jbbjarnason/hot-tub/tub.png

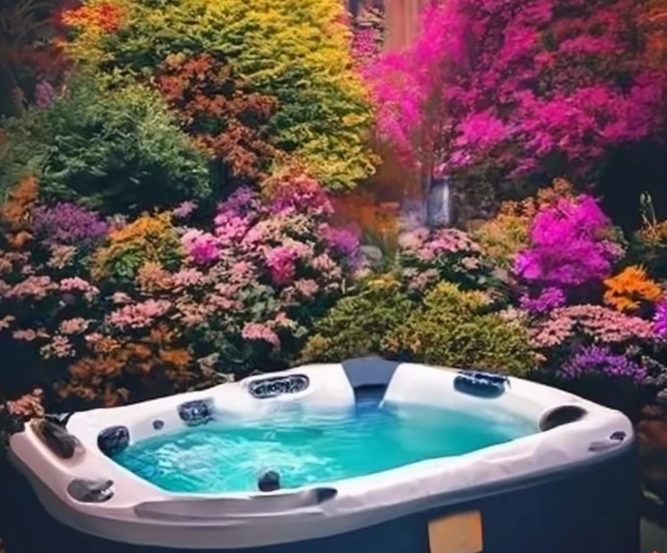
tub.png
