jbbjarnason/hot-tub/tub2.jpg

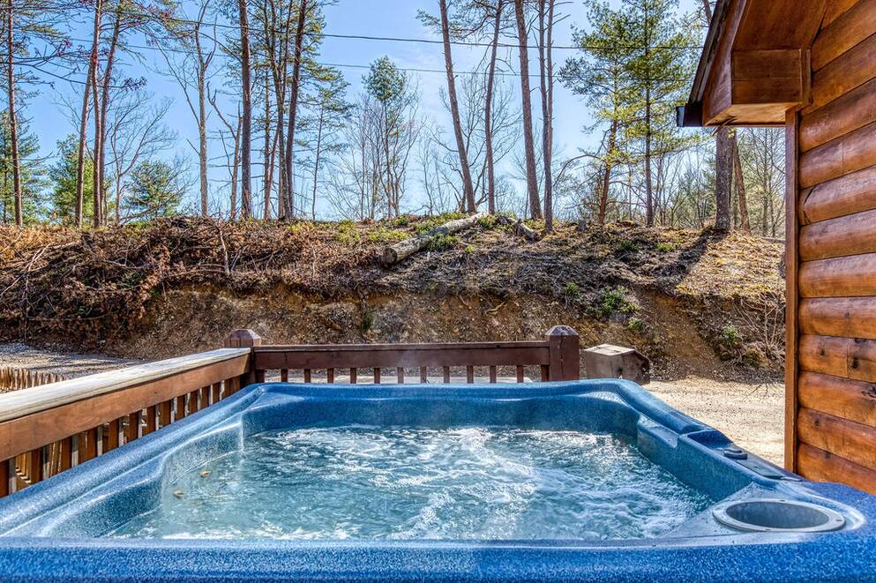
tub2.jpg
