jbbjarnason/hot-tub/readme.md

# resources

https://github.com/m5stack/M5Module-2Relay-13.2
https://github.com/nielsnl68/esphome-components/tree/main/components/m5stack4relay
