jbbjarnason/hot-tub/tub.jpg

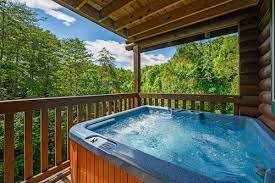
tub.jpg
