jbbjarnason/hot-tub/pcb/jacuzzi.kicad_pcb

## KiCad design pcb/jacuzzi.kicad_pcb (2024-08-04)

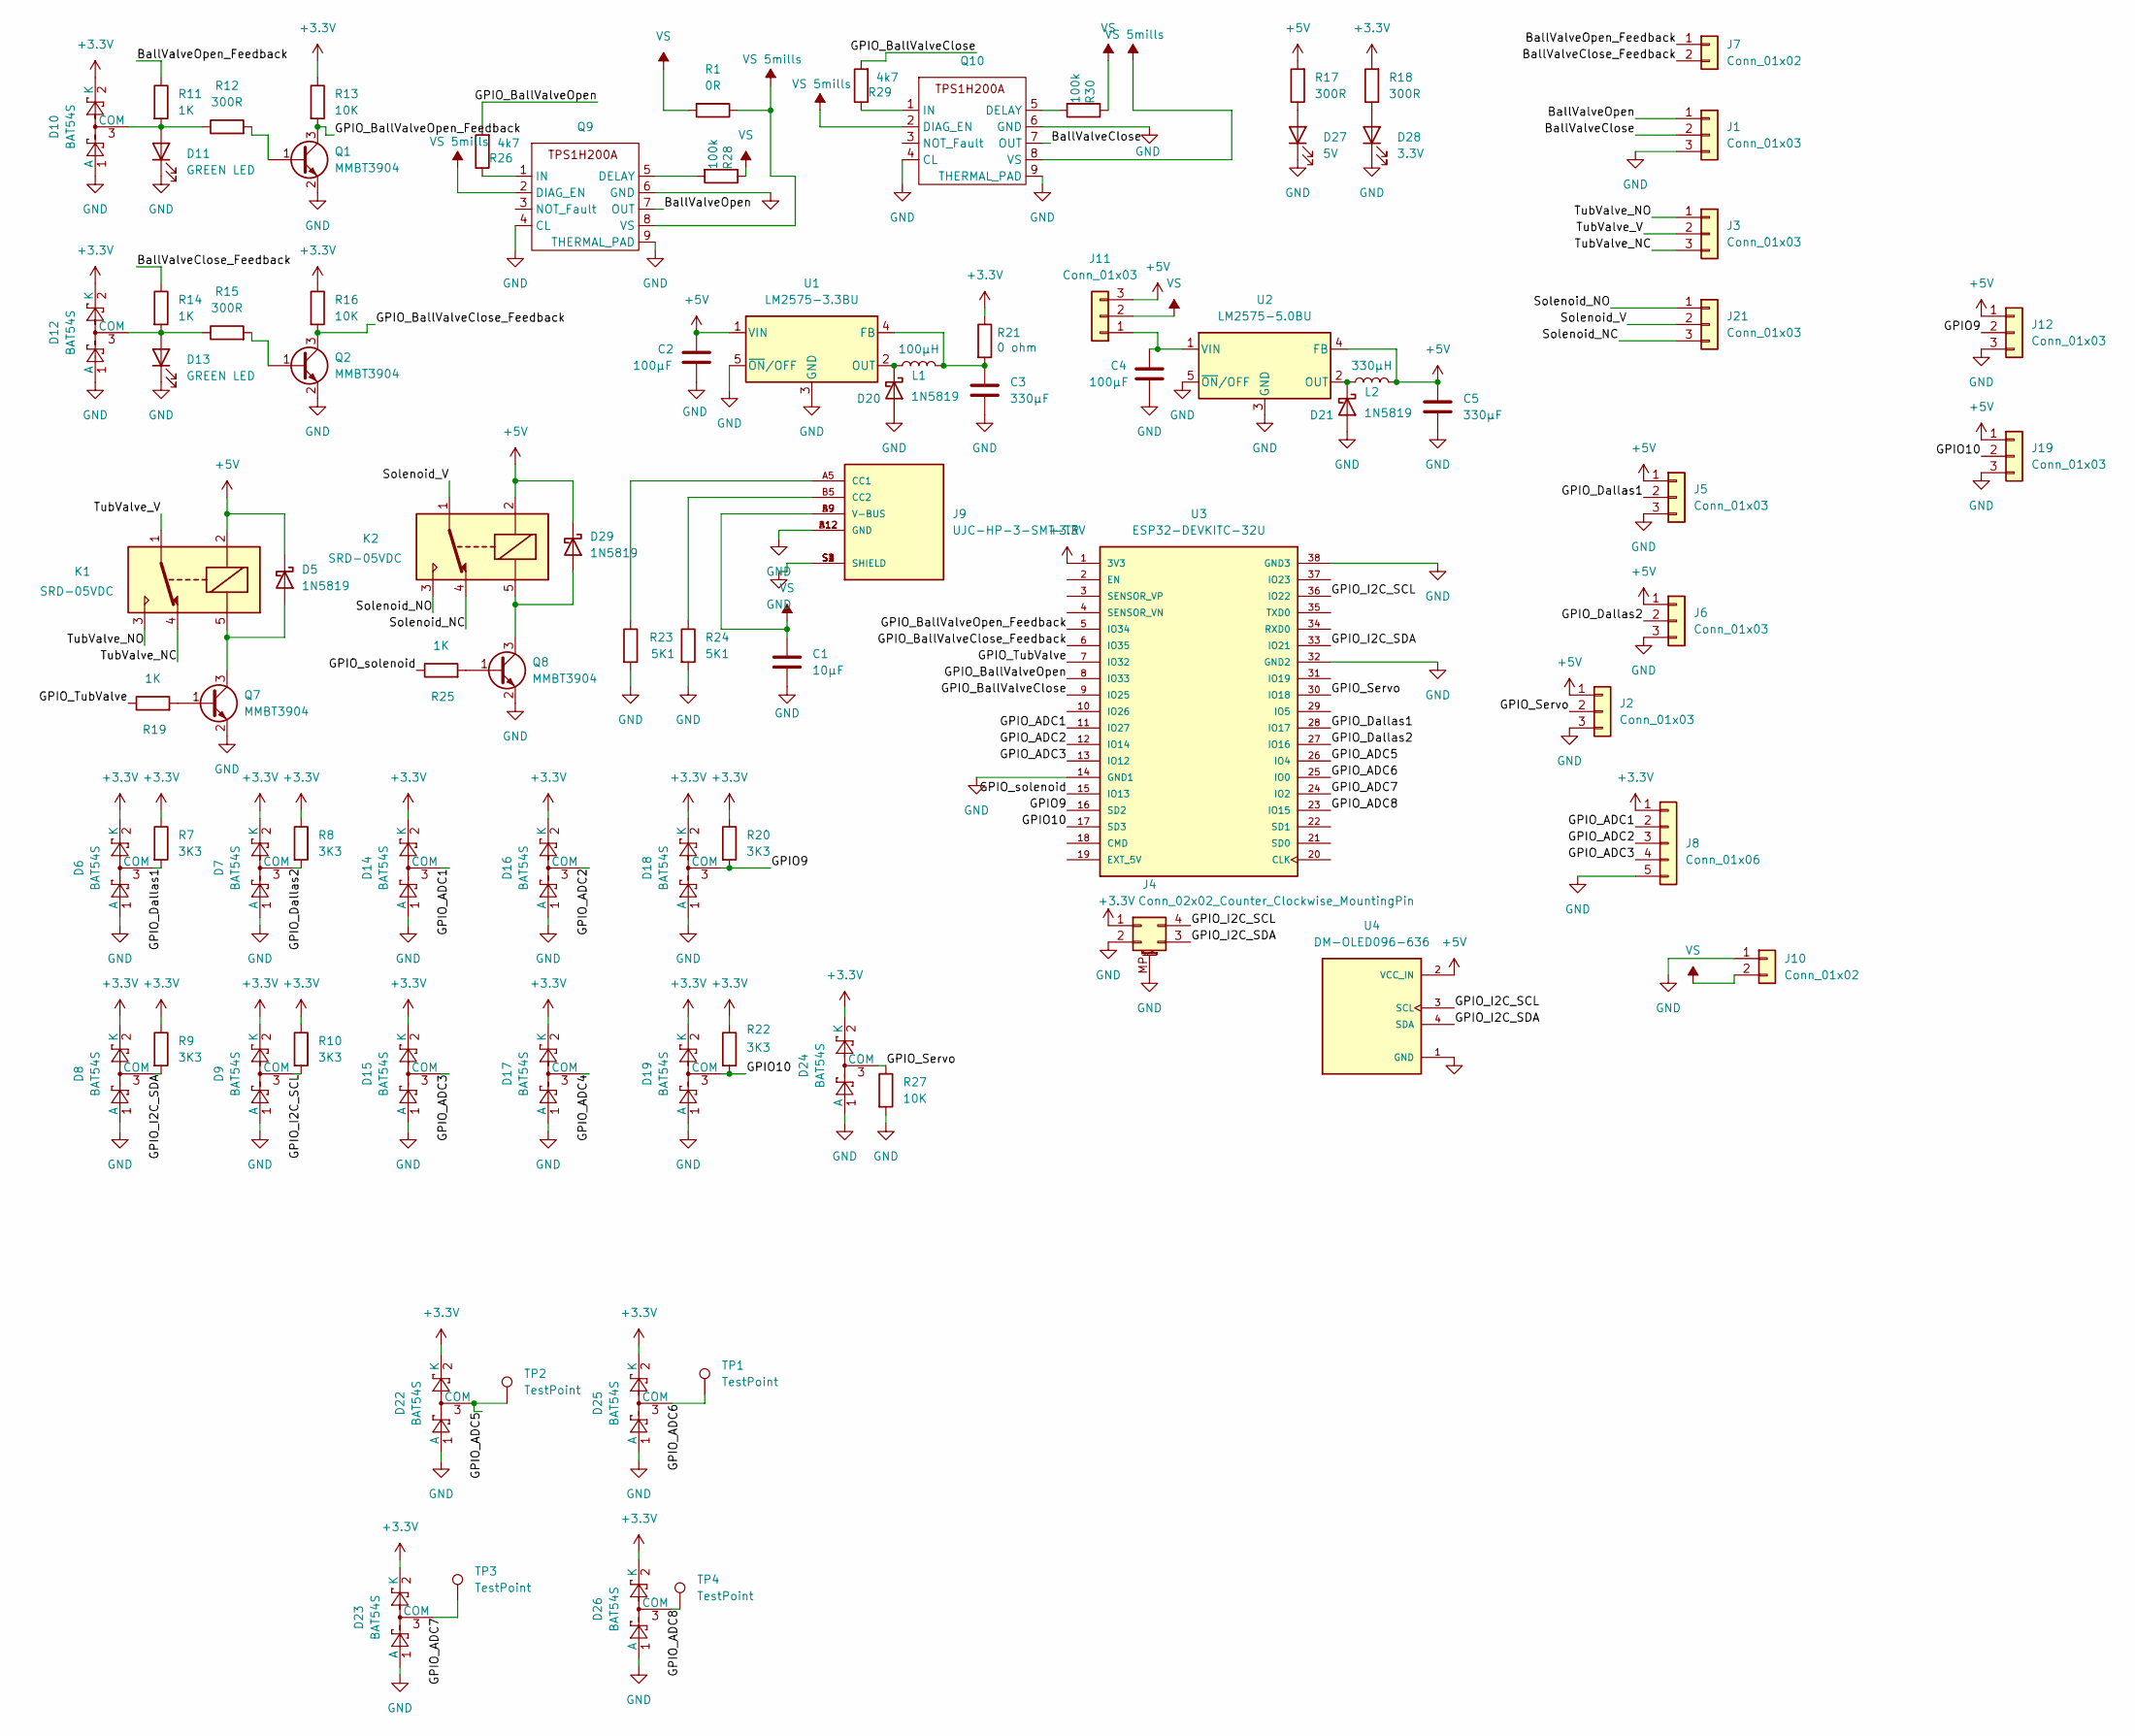
[picture p4: schematic jacuzzi.kicad_sch]

Parts:
C1: 10µF; C_0805_2012Metric; LCSC C15850
C2, C4: 100µF; CP_Elec_8x10; LCSC C116241
C3, C5: 330µF; CP_Elec_6.3x7.7; LCSC C74623
D5, D20, D21, D29: 1N5819; D_SOD-323; LCSC C191023
D6, D7, D8, D9, D10, D12, D14, D15, D16, D17, D18, D19, D22, D23, D24, D25, D26: BAT54S; SOT-23; LCSC C916425
D11, D13: GREEN LED; LED_0805_2012Metric; LCSC C2296
D27: 5V; LED_0805_2012Metric; LCSC C2296
D28: 3.3V; LED_0805_2012Metric; LCSC C2296
J1, J2, J5, J6, J12, J19: Conn_01x03; PhoenixContact_MCV_1,5_3-G-3.81_1x03_P3.81mm_Vertical; LCSC C480525
J3, J21: Conn_01x03; PhoenixContact_MCV_1,5_3-G-5.08_1x03_P5.08mm_Vertical; LCSC C480509
J4: Conn_02x02_Counter_Clockwise_MountingPin; JST_SH_SM04B-SRSS-TB_1x04-1MP_P1.00mm_Horizontal
J7, J10: Conn_01x02; PhoenixContact_MCV_1,5_2-G-3.81_1x02_P3.81mm_Vertical; LCSC C480514
J8: Conn_01x06; PinHeader_1x05_P2.54mm_Vertical; LCSC C37208
J9: UJC-HP-3-SMT-TR; CUI_UJC-HP-3-SMT-TR; PARTREV 04/30/2020; LCSC C668623
J11: Conn_01x03; PinHeader_1x03_P2.54mm_Vertical; LCSC C5160786
K1, K2: SRD-05VDC; Relay_SPDT_SANYOU_SRD_Series_Form_C; LCSC C35449
L1: 100µH; L_Sunlord_SWRB1207S; LCSC C169378
L2: 330µH; L_Sunlord_SWRB1207S; LCSC C169381
Q1, Q2, Q7, Q8: MMBT3904; SOT-23; LCSC C2891808
Q9, Q10: HVSSOP-8-1EP_3x3mm_P0.65mm_EP1.57x1.89mm; LCSC C2653785
R1: 0R; R_0805_2012Metric; LCSC C17617
R7, R8, R9, R10, R20, R22: 3K3; R_0805_2012Metric; LCSC C26010
R11, R14, R19, R25: 1K; R_0805_2012Metric; LCSC C17513
R12, R15, R17, R18: 300R; R_0805_2012Metric; LCSC C17617
R13, R16, R27: 10K; R_0805_2012Metric; LCSC C17414
R21: 0 ohm; R_0805_2012Metric; LCSC C17477
R23, R24: 5K1; R_0805_2012Metric; LCSC C27834
R26, R29: 4k7; R_0805_2012Metric; LCSC C26010
R28, R30: 100k; R_0805_2012Metric; LCSC C26010
TP1, TP2, TP3, TP4: TestPoint; TestPoint_Pad_D4.0mm
U1: LM2575-3.3BU; TO-263-5_TabPin3; LCSC C347404
U2: LM2575-5.0BU; TO-263-5_TabPin3; LCSC C316680
U3: ESP32-DEVKITC-32U; MODULE_ESP32-DEVKITC-32U; PARTREV V4
U4: DM-OLED096-636; MODULE_DM-OLED096-636; PARTREV 2018-09-10; LCSC C5248080

Connections:
+3.3V: D6.2 (K), D7.2 (K), D8.2 (K), D9.2 (K), D10.2 (K), D12.2 (K), D14.2 (K), D15.2 (K), D16.2 (K), D17.2 (K), D18.2 (K), D19.2 (K), D22.2 (K), D23.2 (K), D24.2 (K), D25.2 (K), D26.2 (K), J4.1, J8.1, R7.1, R8.1, R9.1, R10.1, R13.1, R16.1, R18.2, R20.1, R21.1, R22.1, U3.1 (3V3)
+5V: C2.1, C5.1, D5.1 (K), D29.1 (K), J2.1, J5.1, J6.1, J11.3, J12.1, J19.1, K1.2, K2.2, L2.2, R17.2, U1.1 (VIN), U2.4 (FB), U4.2 (VCC_IN)
/BallValveClose: J1.2, Q10.7 (OUT)
/BallValveClose_Feedback: J7.2, R14.1
/BallValveOpen: J1.1, Q9.7 (OUT)
/BallValveOpen_Feedback: J7.1, R11.1
/GPIO9: D18.3 (COM), J12.2, R20.2, U3.16 (SD2)
/GPIO10: D19.3 (COM), J19.2, R22.2, U3.17 (SD3)
/GPIO_ADC1: D14.3 (COM), J8.2, U3.11 (IO27)
/GPIO_ADC2: D16.3 (COM), J8.3, U3.12 (IO14)
/GPIO_ADC3: D15.3 (COM), J8.4, U3.13 (IO12)
/GPIO_ADC4: D17.3 (COM)
/GPIO_ADC5: D22.3 (COM), TP2.1, U3.26 (IO4)
/GPIO_ADC6: D25.3 (COM), TP1.1, U3.25 (IO0)
/GPIO_ADC7: D23.3 (COM), TP3.1, U3.24 (IO2)
/GPIO_ADC8: D26.3 (COM), TP4.1, U3.23 (IO15)
/GPIO_BallValveClose: R29.2, U3.9 (IO25)
/GPIO_BallValveClose_Feedback: Q2.3 (C), R16.2, U3.6 (IO35)
/GPIO_BallValveOpen: R26.2, U3.8 (IO33)
/GPIO_BallValveOpen_Feedback: Q1.3 (C), R13.2, U3.5 (IO34)
/GPIO_Dallas1: D6.3 (COM), J5.2, R7.2, U3.28 (IO17)
/GPIO_Dallas2: D7.3 (COM), J6.2, R8.2, U3.27 (IO16)
/GPIO_I2C_SCL: D9.3 (COM), J4.4, R10.2, U3.36 (IO22), U4.3 (SCL)
/GPIO_I2C_SDA: D8.3 (COM), J4.3, R9.2, U3.33 (IO21), U4.4 (SDA)
/GPIO_Servo: D24.3 (COM), J2.2, R27.1, U3.30 (IO18)
/GPIO_TubValve: R19.1, U3.7 (IO32)
/GPIO_solenoid: R25.1, U3.15 (IO13)
/Solenoid_NC: J21.3, K2.4
/Solenoid_NO: J21.1, K2.3
/Solenoid_V: J21.2, K2.1
/TubValve_NC: J3.3, K1.4
/TubValve_NO: J3.1, K1.3
/TubValve_V: J3.2, K1.1
GND: C1.2, C2.2, C3.2, C4.2, C5.2, D6.1 (A), D7.1 (A), D8.1 (A), D9.1 (A), D10.1 (A), D11.1 (K), D12.1 (A), D13.1 (K), D14.1 (A), D15.1 (A), D16.1 (A), D17.1 (A), D18.1 (A), D19.1 (A), D20.2 (A), D21.2 (A), D22.1 (A), D23.1 (A), D24.1 (A), D25.1 (A), D26.1 (A), D27.1 (K), D28.1 (K), J1.3, J2.3, J4.2, J4.MP (MountPin), J5.3, J6.3, J8.5, J9.A12 (GND), J9.B12 (GND), J9.S1 (SHIELD), J9.S2 (SHIELD), J9.S3 (SHIELD), J9.S4 (SHIELD), J10.1, J12.3, J19.3, Q1.2 (E), Q2.2 (E), Q7.2 (E), Q8.2 (E), Q9.4 (CL), Q9.6 (GND), Q9.9 (THERMAL_PAD), Q10.4 (CL), Q10.6 (GND), Q10.9 (THERMAL_PAD), R23.2, R24.2, R27.2, U1.3 (GND), U1.5 (~ON/OFF), U2.3 (GND), U2.5 (~ON/OFF), U3.14 (GND1), U3.32 (GND2), U3.38 (GND3), U4.1 (GND)
unnamed: D5.2 (A), K1.5, Q7.3 (C)
unnamed: D10.3 (COM), D11.2 (A), R11.2, R12.1
unnamed: D12.3 (COM), D13.2 (A), R14.2, R15.1
unnamed: D20.1 (K), L1.1, U1.2 (OUT)
unnamed: D21.1 (K), L2.1, U2.2 (OUT)
unnamed: D27.2 (A), R17.1
unnamed: D28.2 (A), R18.1
unnamed: D29.2 (A), K2.5, Q8.3 (C)
unnamed: J9.A5 (CC1), R23.1
unnamed: J9.B5 (CC2), R24.1
unnamed: C4.1, J11.1, U2.1 (VIN)
unnamed: Q1.1 (B), R12.2
unnamed: Q2.1 (B), R15.2
unnamed: Q7.1 (B), R19.2
unnamed: Q8.1 (B), R25.2
unnamed: Q9.5 (DELAY), R28.2
unnamed: Q9.1 (IN), R26.1
unnamed: Q10.5 (DELAY), R30.2
unnamed: Q10.1 (IN), R29.1
unnamed: C3.1, L1.2, R21.2, U1.4 (FB)
VS: C1.1, J9.A9 (V-BUS), J9.B9 (V-BUS), J10.2, J11.2, R1.2, R28.1, R30.1
VS 5mills: Q9.2 (DIAG_EN), Q9.8 (VS), Q10.2 (DIAG_EN), Q10.8 (VS), R1.1

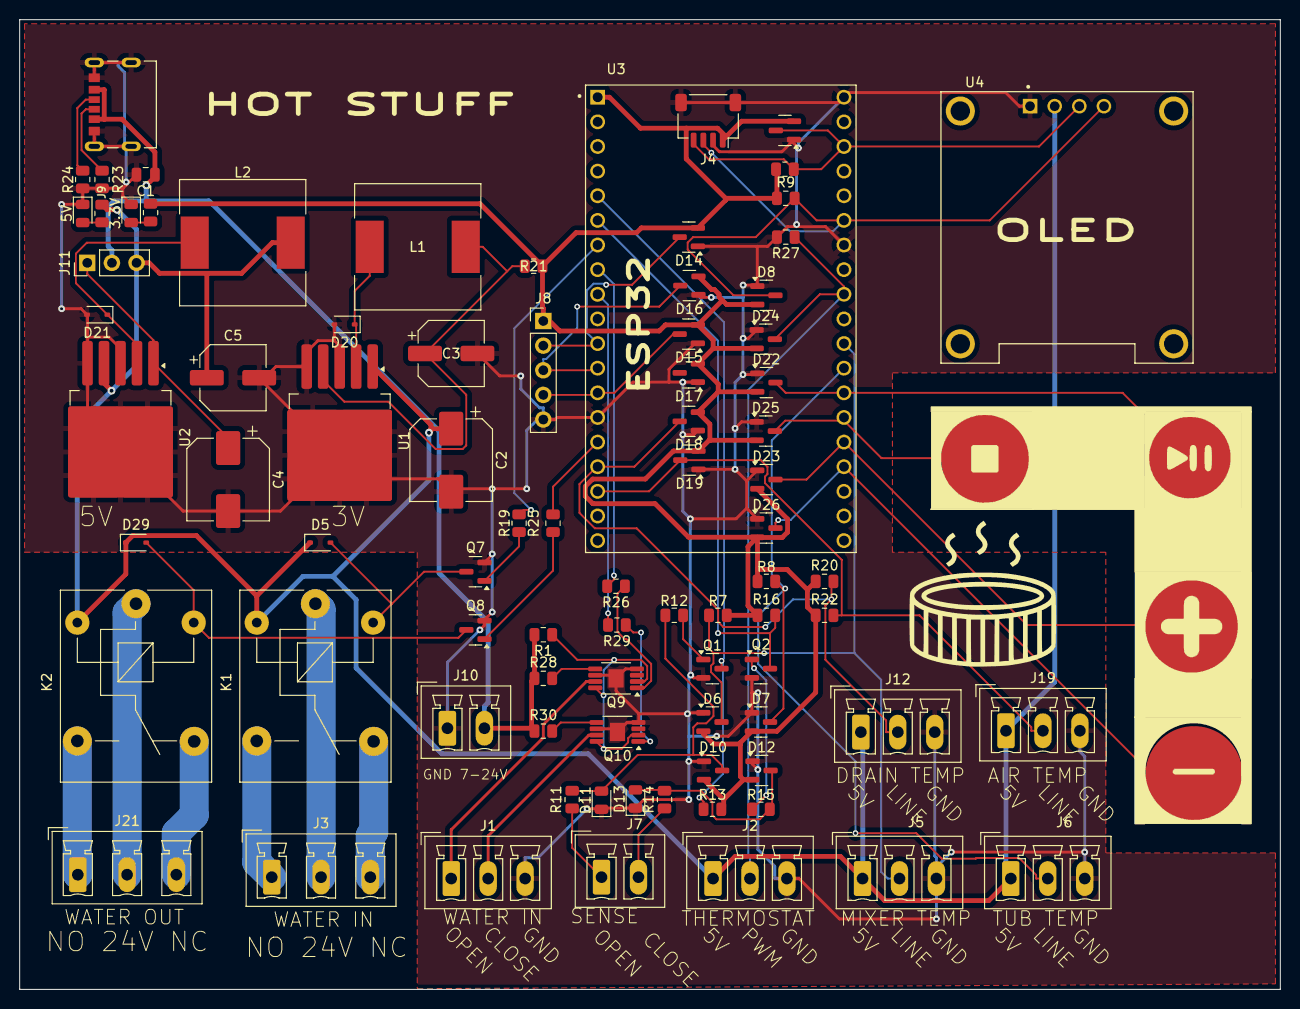
[picture p5: board jacuzzi.kicad_pcb from above]

Board: 2 copper layers, 130.0 x 100.0 mm, 91 parts (0 on the bottom side), 55 nets.

Other parts of the board:
J13, J14, J15, J16: LOGO
