jbbjarnason/hot-tub/(commit log)

2023-08-20 add m5stack relay 2 support
2023-08-20 m5stack relays
2023-08-25 add dallas sensors
2023-08-26 siemens pid working
2023-08-26 pid for valve
2023-10-06 now will remember run state after power fail
    [hot-tub.yml]
2024-03-28 currently at vidibrekka
2024-03-29 explode in some changes, nothing tested but servo climate now compiles
2024-07-03 empty pcb project
    [jacuzzi.kicad_pcb, jacuzzi.kicad_sch]
2024-07-03 add ball valve circuit, tub valve circuit, input protections
    [jacuzzi.kicad_sch]
2024-07-03 add kicad_pro file
2024-07-03 now using l293dd
    [jacuzzi.kicad_sch]
2024-07-05 testing if fymbols and foot print work when added to project
    [jacuzzi.kicad_sch]
2024-07-09 use cheap p channels instead of motor circuit, add usb c, add buck converter, switch to smd bjts
    [jacuzzi.kicad_sch]
2024-07-10 add around buck converter
    [jacuzzi.kicad_sch]
2024-07-12 some things with jon
    [jacuzzi.kicad_sch]
2024-07-13 working on fixing 5V and voltage supply
    [jacuzzi.kicad_sch]
2024-07-13 schematic is now testable and should be layed out
    [jacuzzi.kicad_sch]
2024-07-13 add missing footprints
    [jacuzzi.kicad_sch]
2024-07-13 started layout
    [jacuzzi.kicad_pcb, jacuzzi.kicad_sch]
2024-07-13 trying to export
    [jacuzzi-B_Cu.gbr, jacuzzi-B_Mask.gbr, jacuzzi-B_Paste.gbr, jacuzzi-B_Silkscreen.gbr, jacuzzi-Edge_Cuts.gbr, jacuzzi-F_Cu.gbr, jacuzzi-F_Mask.gbr, jacuzzi-F_Paste.gbr]
2024-07-13 started on bom
    [jacuzzi.kicad_pcb, jacuzzi.kicad_sch]
2024-07-13 cleanup on pcb and added grapics. need to make a logo
    [jacuzzi.kicad_pcb]
2024-07-13 add diode for 3v and 5v, missing markings on pcb
    [jacuzzi.kicad_pcb, jacuzzi.kicad_sch]
2024-07-13 add transistor to drive 5v on relay
    [jacuzzi.kicad_pcb, jacuzzi.kicad_sch]
2024-07-14 now with all parts defined
    [jacuzzi.kicad_pcb, jacuzzi.kicad_sch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]
2024-07-16 issue with usb change the footprint
    [jacuzzi.kicad_pcb]
2024-07-25 added k2 and chagend the output fet ready for rewive
    [jacuzzi.kicad_pcb, jacuzzi.kicad_sch]
2024-07-28 fixed part list
    [jacuzzi-B_Cu.gbr, jacuzzi-B_Mask.gbr, jacuzzi-B_Paste.gbr, jacuzzi-B_Silkscreen.gbr, jacuzzi-Edge_Cuts.gbr, jacuzzi-F_Cu.gbr, jacuzzi-F_Mask.gbr, jacuzzi-F_Paste.gbr]
2024-08-04 move q9 and q10 and set 0.3mm track width for ball valve open and close and move the solenoid connector apart
    [jacuzzi.kicad_pcb]
2024-08-04 moved the relay connector
    [jacuzzi.kicad_pcb]
2024-08-04 fixed resistor label
    [jacuzzi.kicad_pcb]
2024-08-04 minor fixes and ordered
    [jacuzzi.kicad_pcb, jacuzzi.kicad_sch]
2024-12-18 old changes dont know what they are
    [jacuzzi.kicad_sch]
